MrTransistorsChannel/TransistorSoldering_V3.0/scheme/pdf/power supply module.pdf

L1 У меня дроссель 15 витков по 1 мм на торе 1,5 см

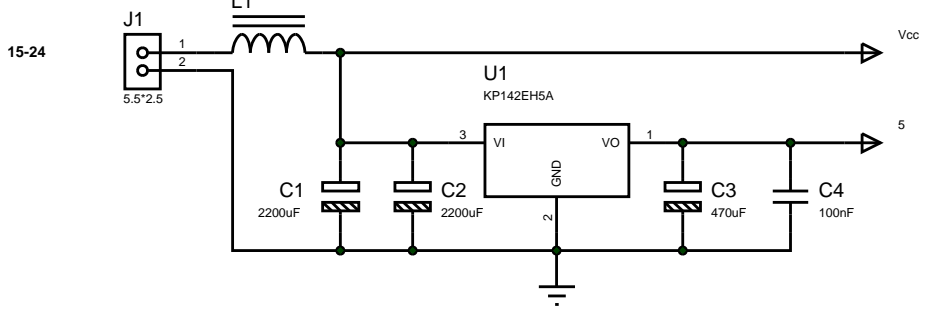
[picture p2: figure]
GND 2; 5 вольт из фильтра питания; Vcc из фильтра питания; В БП 15-24 вольта
