MrTransistorsChannel/TransistorSoldering_V3.0/scheme/pdf/mosfet module.pdf

Q1
R1 | IRF3205

1k
R2

10k

На выход Vcc из фильтра питания

В нагреватель

На пин А1 Ардуино
