MrTransistorsChannel/TransistorSoldering_V3.0/scheme/pdf/thermocouple amplifier.pdf

На 5 вольт из платы фильтра питания

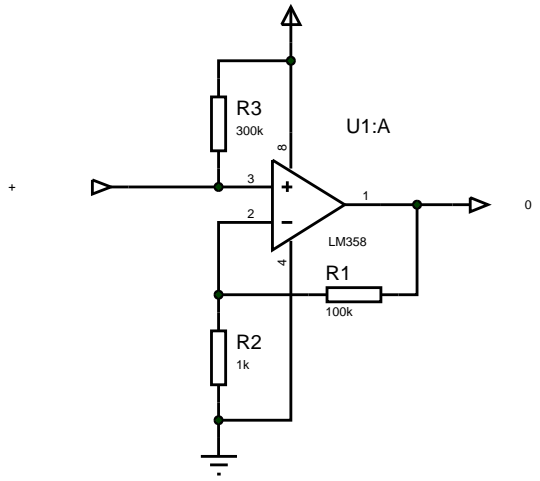
[picture p3: figure]
На + термопары; На А0 Ардуино
