MrTransistorsChannel/TransistorSoldering_V3.0/scheme/bmp/Модуль питания.png

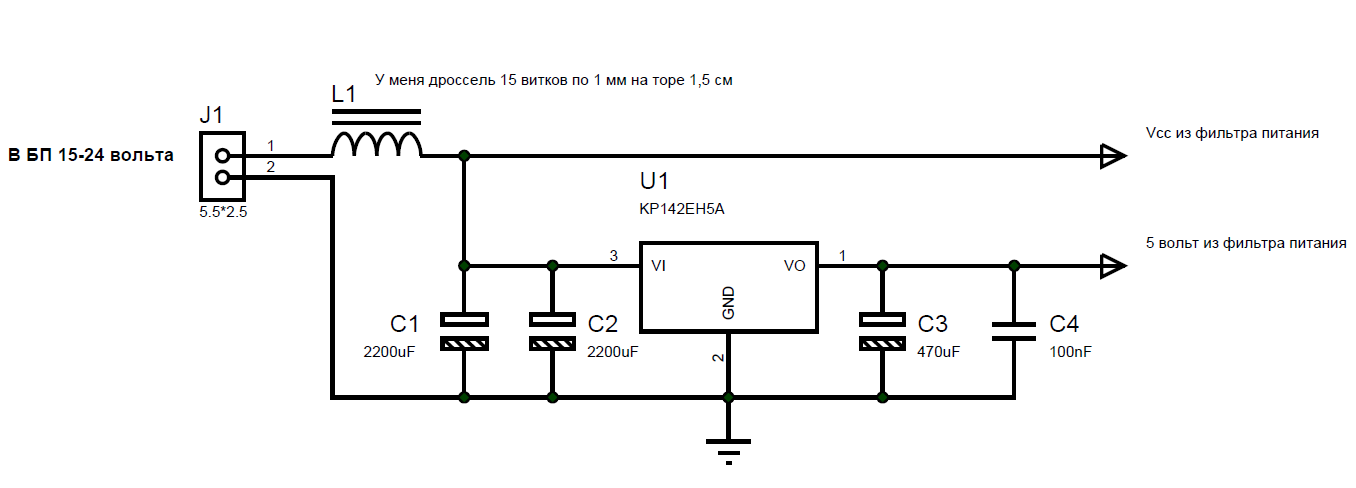
scheme/bmp/Модуль питания.png
