MrTransistorsChannel/TransistorSoldering_V3.0/scheme/bmp/Модуль силового ключа.png

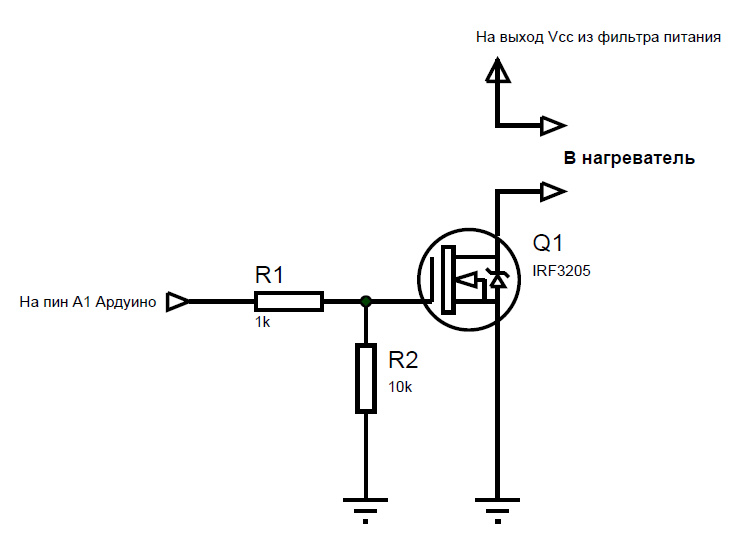
scheme/bmp/Модуль силового ключа.png
