MrTransistorsChannel/TransistorSoldering_V3.0/scheme/bmp/Основная часть.png

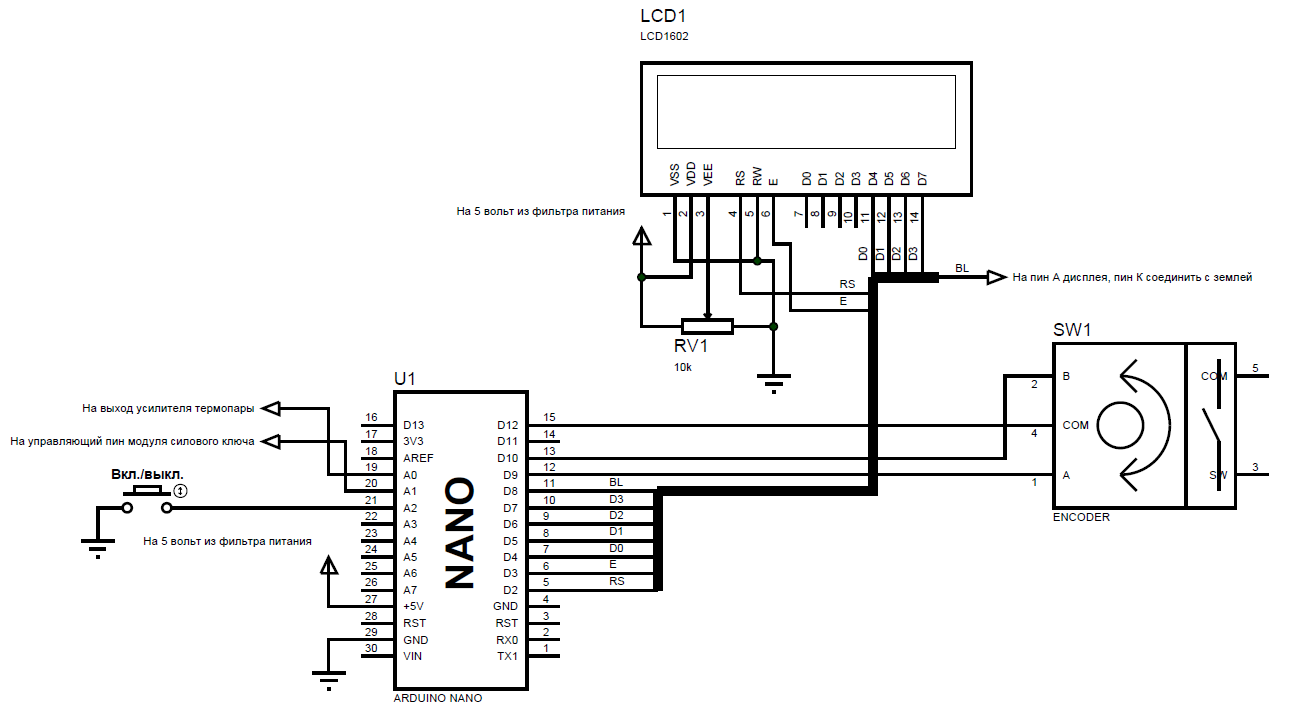
scheme/bmp/Основная часть.png
