MrTransistorsChannel/TransistorSoldering_V3.0/scheme/bmp/Усилитель термопары.png

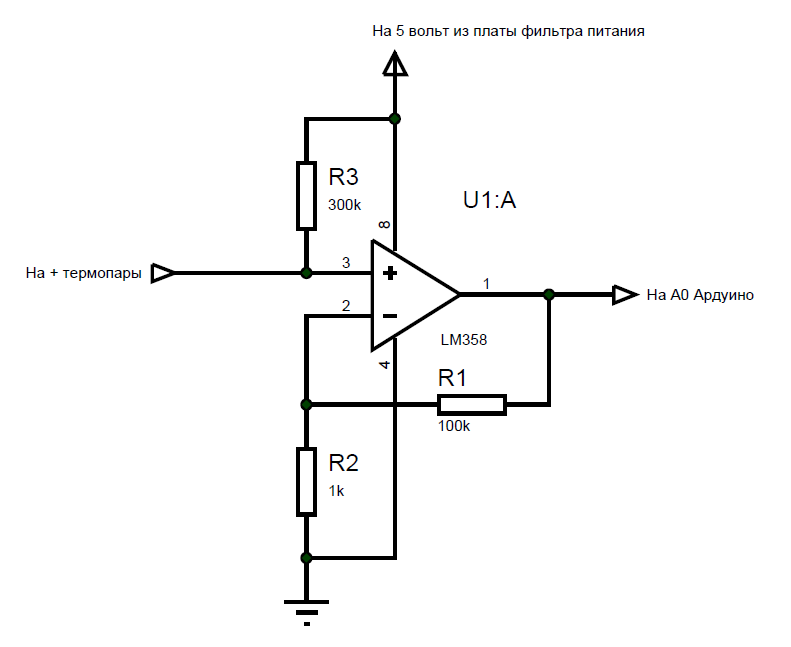
scheme/bmp/Усилитель термопары.png
