MrTransistorsChannel/TransistorSoldering_V3.0/scheme/pdf/main.pdf

## LCD1

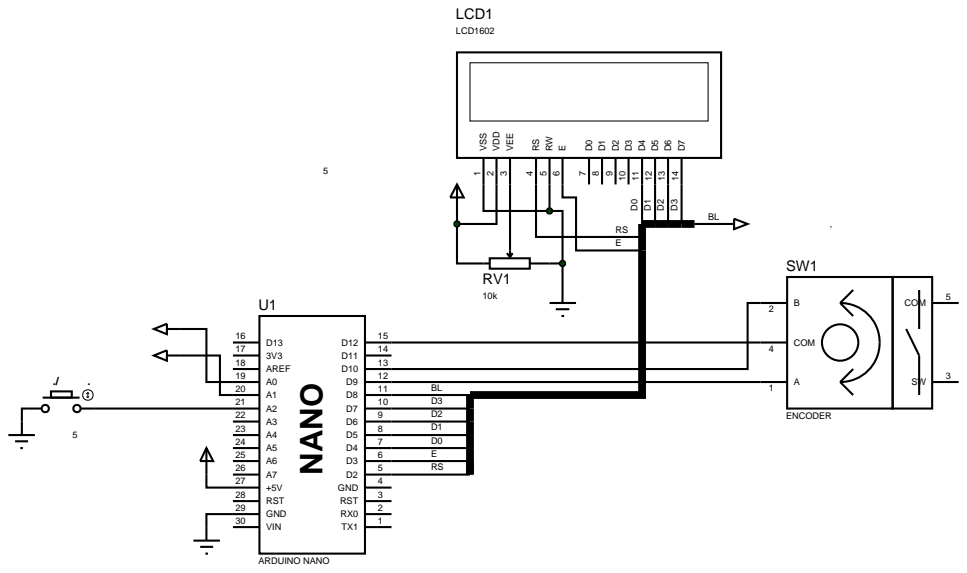
[picture p8: page 1]

На 5 вольт из фильтра питания

На пин А дисплея, пин К соединить с землей

На выход усилителя термопары

На управляющий пин модуля силового ключа
